hoglet67/ReTuLaReMake/kicad/ReTuLaReMake.pdf

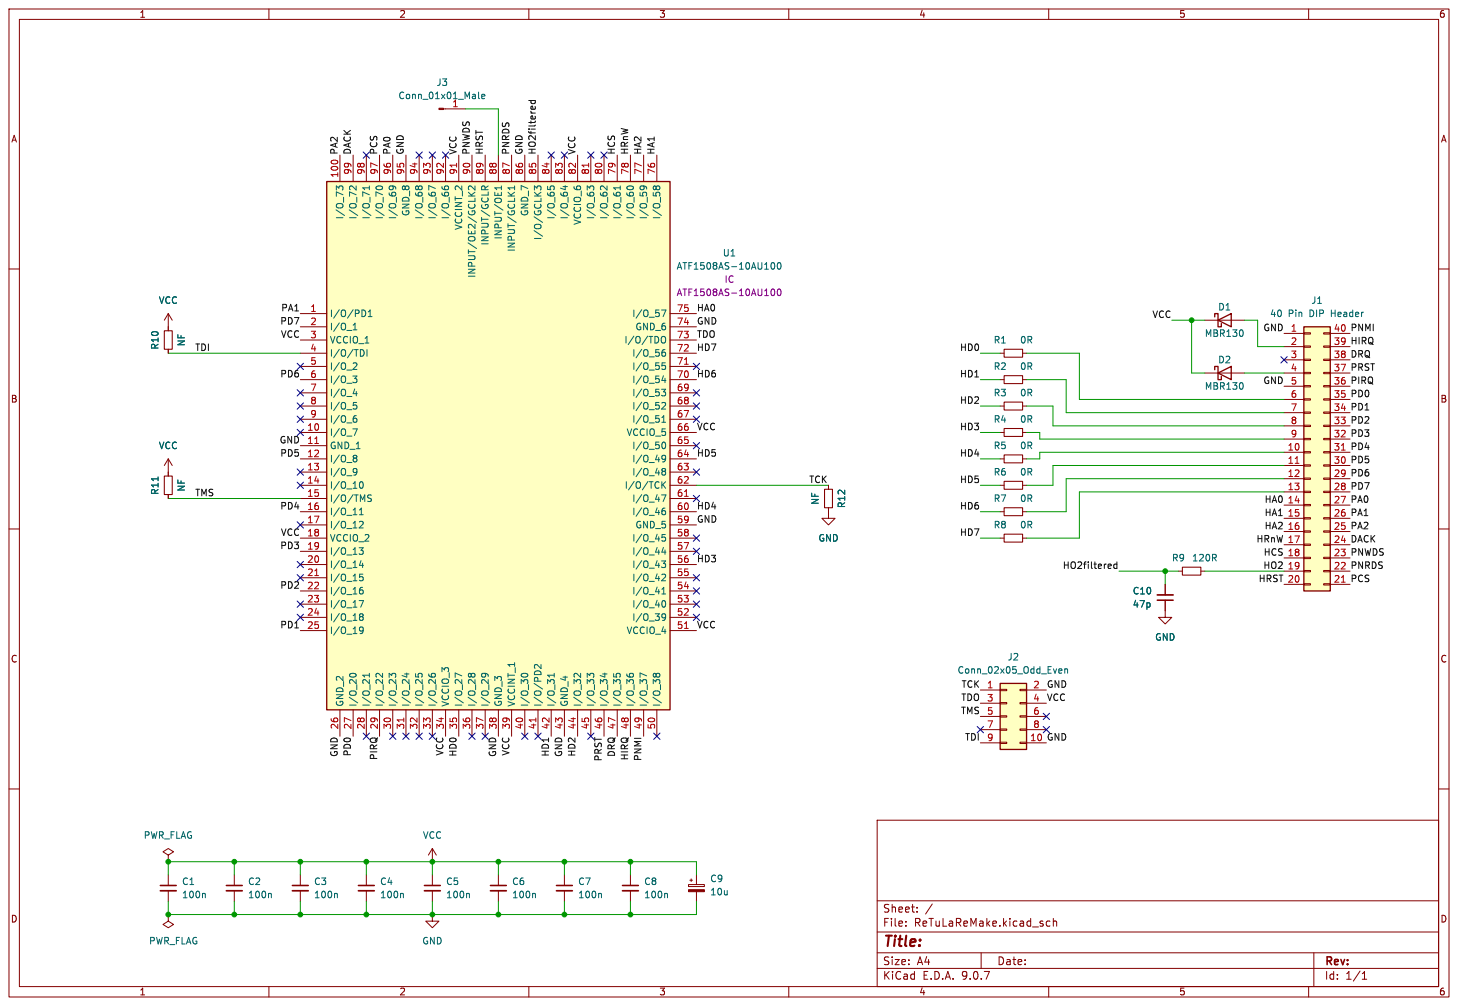
[picture p1: page 1]

Id: 1/1 Title: File: ReTuLaReMake.kicad_sch Sheet: /
