hoglet67/ReTuLaReMake/kicad_jk/ReTuLaReMake.kicad_pcb

## KiCad design kicad_jk/ReTuLaReMake.kicad_pcb (2023-12-09)

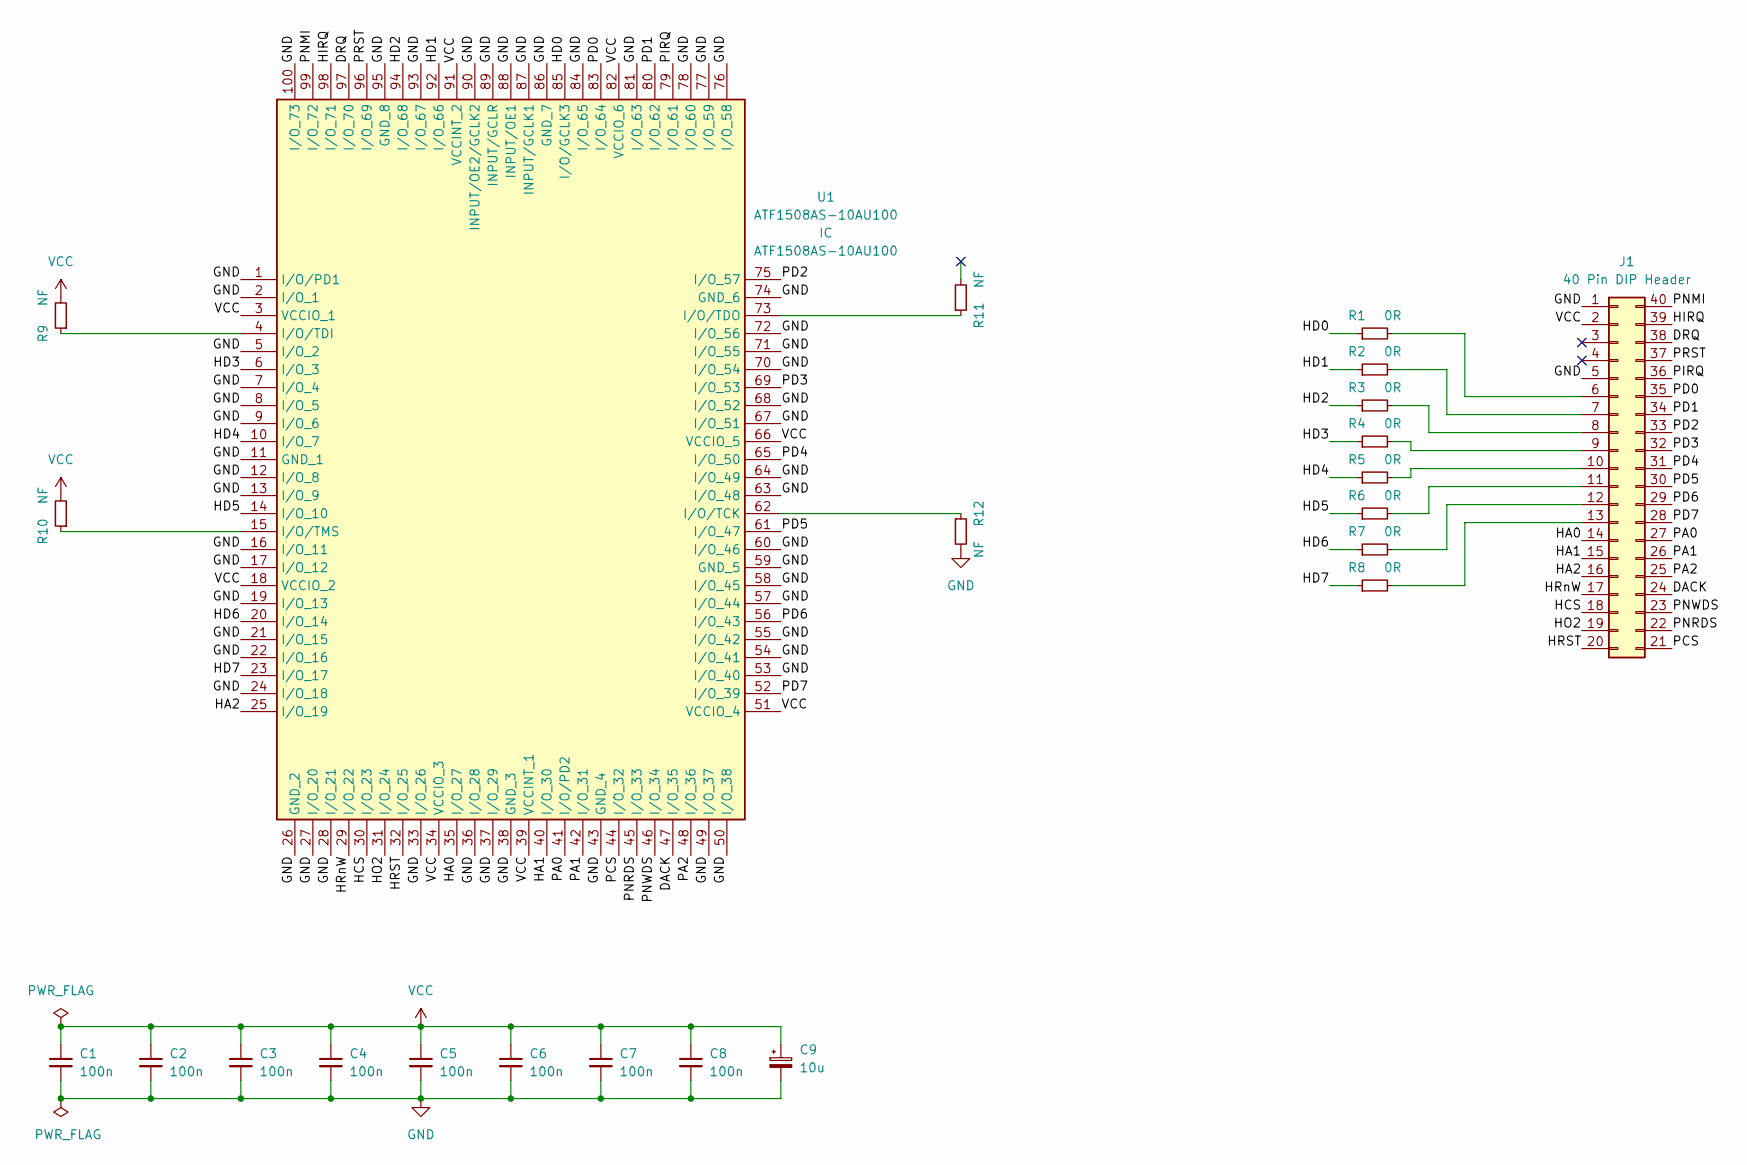
[picture p5: schematic ReTuLaReMake.kicad_sch]

Parts:
C1, C2, C3, C4, C5, C6, C7, C8: 100n; C_0805_2012Metric_Pad1.18x1.45mm_HandSolder
C9: 10u; CP_EIA-6032-28_Kemet-C_Pad2.25x2.35mm_HandSolder
J1: 40 Pin DIP Header; DIP-40_W15.24mm_Header
R1, R2, R3, R4, R5, R6, R7, R8: 0R; R_0805_2012Metric_Pad1.20x1.40mm_HandSolder
R9, R10, R11, R12: NF; R_1206_3216Metric
U1: ATF1508AS-10AU100; TQFP-100_14x14mm_P0.5mm; Manufacturer_Part_Number ATF1508AS-10AU100; Mouser Part Number 556-AF1508AS10AU100

Connections:
/DACK: J1.24, U1.47 (I/O_35)
/DRQ: J1.38, U1.97 (I/O_70)
/HA0: J1.14, U1.35 (I/O_27)
/HA1: J1.15, U1.40 (I/O_30)
/HA2: J1.16, U1.25 (I/O_19)
/HCS: J1.18, U1.30 (I/O_23)
/HD0: R1.1, U1.85 (I/O/GCLK3)
/HD1: R2.1, U1.92 (I/O_66)
/HD2: R3.1, U1.94 (I/O_68)
/HD3: R4.1, U1.6 (I/O_3)
/HD4: R5.1, U1.10 (I/O_7)
/HD5: R6.1, U1.14 (I/O_10)
/HD6: R7.1, U1.20 (I/O_14)
/HD7: R8.1, U1.23 (I/O_17)
/HIRQ: J1.39, U1.98 (I/O_71)
/HO2: J1.19, U1.31 (I/O_24)
/HRST: J1.20, U1.32 (I/O_25)
/HRnW: J1.17, U1.29 (I/O_22)
/PA0: J1.27, U1.41 (I/O/PD2)
/PA1: J1.26, U1.42 (I/O_31)
/PA2: J1.25, U1.48 (I/O_36)
/PCS: J1.21, U1.44 (I/O_32)
/PD0: J1.35, U1.83 (I/O_64)
/PD1: J1.34, U1.80 (I/O_62)
/PD2: J1.33, U1.75 (I/O_57)
/PD3: J1.32, U1.69 (I/O_53)
/PD4: J1.31, U1.65 (I/O_50)
/PD5: J1.30, U1.61 (I/O_47)
/PD6: J1.29, U1.56 (I/O_43)
/PD7: J1.28, U1.52 (I/O_39)
/PIRQ: J1.36, U1.79 (I/O_61)
/PNMI: J1.40, U1.99 (I/O_72)
/PNRDS: J1.22, U1.45 (I/O_33)
/PNWDS: J1.23, U1.46 (I/O_34)
/PRST: J1.37, U1.96 (I/O_69)
GND: C1.2, C2.2, C3.2, C4.2, C5.2, C6.2, C7.2, C8.2, C9.2, J1.1, J1.5, R12.2, U1.1 (I/O/PD1), U1.2 (I/O_1), U1.5 (I/O_2), U1.7 (I/O_4), U1.8 (I/O_5), U1.9 (I/O_6), U1.11 (GND_1), U1.12 (I/O_8), U1.13 (I/O_9), U1.16 (I/O_11), U1.17 (I/O_12), U1.19 (I/O_13), U1.21 (I/O_15), U1.22 (I/O_16), U1.24 (I/O_18), U1.26 (GND_2), U1.27 (I/O_20), U1.28 (I/O_21), U1.33 (I/O_26), U1.36 (I/O_28), U1.37 (I/O_29), U1.38 (GND_3), U1.43 (GND_4), U1.49 (I/O_37), U1.50 (I/O_38), U1.53 (I/O_40), U1.54 (I/O_41), U1.55 (I/O_42), U1.57 (I/O_44), U1.58 (I/O_45), U1.59 (GND_5), U1.60 (I/O_46), U1.63 (I/O_48), U1.64 (I/O_49), U1.67 (I/O_51), U1.68 (I/O_52), U1.70 (I/O_54), U1.71 (I/O_55), U1.72 (I/O_56), U1.74 (GND_6), U1.76 (I/O_58), U1.77 (I/O_59), U1.78 (I/O_60), U1.81 (I/O_63), U1.84 (I/O_65), U1.86 (GND_7), U1.87 (INPUT/GCLK1), U1.88 (INPUT/OE1), U1.89 (INPUT/GCLR), U1.90 (INPUT/OE2/GCLK2), U1.93 (I/O_67), U1.95 (GND_8), U1.100 (I/O_73)
unnamed: J1.6, R1.2
unnamed: J1.7, R2.2
unnamed: J1.8, R3.2
unnamed: J1.9, R4.2
unnamed: J1.10, R5.2
unnamed: J1.11, R6.2
unnamed: J1.12, R7.2
unnamed: J1.13, R8.2
unnamed: R9.1, U1.4 (I/O/TDI)
unnamed: R10.1, U1.15 (I/O/TMS)
unnamed: R11.1, U1.73 (I/O/TDO)
unnamed: R12.1, U1.62 (I/O/TCK)
VCC: C1.1, C2.1, C3.1, C4.1, C5.1, C6.1, C7.1, C8.1, C9.1, J1.2, R9.2, R10.2, U1.3 (VCCIO_1), U1.18 (VCCIO_2), U1.34 (VCCIO_3), U1.39 (VCCINT_1), U1.51 (VCCIO_4), U1.66 (VCCIO_5), U1.82 (VCCIO_6), U1.91 (VCCINT_2)

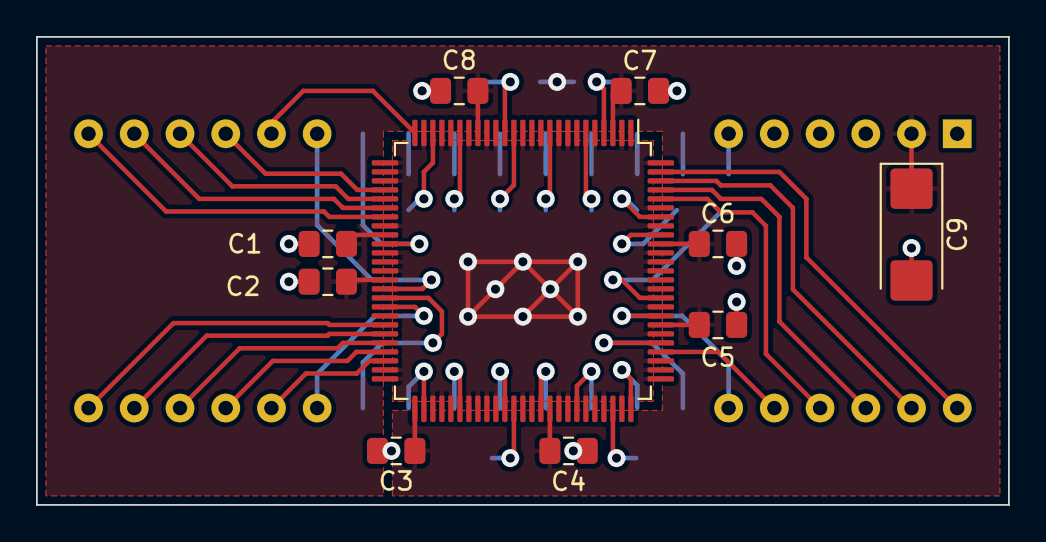
[picture p6: board kicad_jk/ReTuLaReMake.kicad_pcb from above]

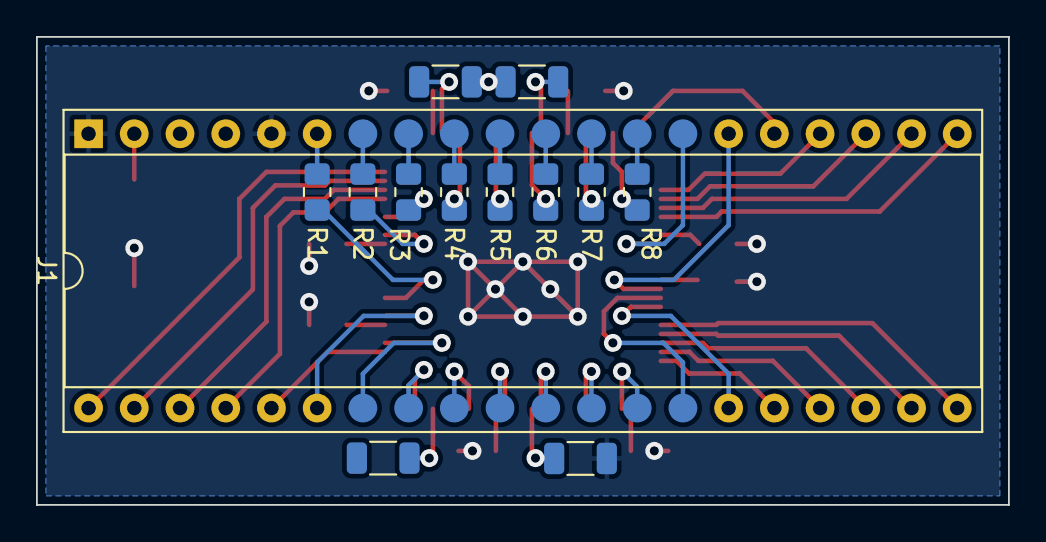
[picture p7: board kicad_jk/ReTuLaReMake.kicad_pcb from below]

Board: 2 copper layers, 54.0 x 26.0 mm, 23 parts (13 on the bottom side), 49 nets.
