hoglet67/ReTuLaReMake/cpld/cupl/simulation/Atmel_Lib.v

//    ---------------------------- Atmel ATF15xx Timing Simulation Library-----------------------------------
//   |Version:                     1.0.3                                                                     |
//   |Last revision date:          01/23/2007                                                                |
//   |Revised by:                  skoutsomitsos                                                             |
//   |                                                                                                       |
//   |Changelog:         1.0.1    -12/19/2006 by skoutsomitsos| New functional models for DFFEARS/TFFEARS    |
//   |                            -12/19/2006 by skoutsomitsos| Corrected timescale and timing values        |                                                          |
//   |                                                          decimals to 1ps                              |
//   |                   1.0.2    -01/12/2007 by ewan         | Set initial state of DFFEARS/TFFEARS to 0    |
//   |                   1.0.3    -01/23/2007 by ewan         | Modified the defined initial state of DFF/TFF|
//    ------------------------------------------------------------------------------------------------------


`timescale 1ns / 1ps

/////////////////////////////////////////////////

module BUF (Q,A);
        output Q;
        input  A;

        buf I1 (Q, A);

 specify
		specparam allZeros = 0:0:0;
                (A +=> Q) = ( allZeros,allZeros);
        endspecify
endmodule // ibuf

/////////////////////////////////////////////////


module INV (QN, A);
	input 	A;
	output 	QN;

not fig1115 ( QN, A );

specify //Path definitions
	(A => QN ) = (0.000:0.000:0.000,0.000:0.000:0.000);

	//Delay Calc Parameter declarations
	specparam fall$A$QN	= 0.000:0.000:0.000;
	specparam rise$A$QN	= 0.000:0.000:0.000;
	specparam load$A	= 1.0;
endspecify
endmodule


////////////////////////////////////////////////

module AND1 (Q, A1);
	input 	A1;
	output 	Q;

buf fig1000 ( Q, A1 );

specify //Path definitions
	(A1 => Q ) = (0.000:0.000:0.000,0.000:0.000:0.000);

	//Delay Calc Parameter declarations
	specparam fall$A1$Q	= 0.000:0.000:0.000;
	specparam rise$A1$Q	= 0.000:0.000:0.000;
	specparam load$A1	= 1.0;
endspecify
endmodule

////////////////////////////////////////////////
module AND2 (Q, A1, A2);
	input 	A1;
	input 	A2;
	output 	Q;

and fig1000 ( Q, A1, A2 );

specify //Path definitions
	(A1 => Q ) = (0.000:0.000:0.000,0.000:0.000:0.000);
	(A2 => Q ) = (0.000:0.000:0.000,0.000:0.000:0.000);

	//Delay Calc Parameter declarations
	specparam fall$A1$Q	= 0.000:0.000:0.000;
	specparam rise$A1$Q	= 0.000:0.000:0.000;
	specparam fall$A2$Q	= 0.000:0.000:0.000;
	specparam rise$A2$Q	= 0.000:0.000:0.000;
	specparam load$A1	= 1.0;
	specparam load$A2	= 1.0;
endspecify
endmodule


//////////////////////////////////////////////////

module AND3 (Q, A1, A2, A3);
	input 	A1;
	input 	A2;
	input 	A3;
	output 	Q;

and fig1211 ( Q, A1, A2, A3);

specify //Path definitions
	(A1 => Q ) = (0.000:0.000:0.000,0.000:0.000:0.000);
	(A2 => Q ) = (0.000:0.000:0.000,0.000:0.000:0.000);
	(A3 => Q ) = (0.000:0.000:0.000,0.000:0.000:0.000);

	//Delay Calc Parameter declarations
	specparam fall$A1$Q	= 0.000:0.000:0.000;
	specparam rise$A1$Q	= 0.000:0.000:0.000;
	specparam fall$A2$Q	= 0.000:0.000:0.000;
	specparam rise$A2$Q	= 0.000:0.000:0.000;
	specparam fall$A3$Q	= 0.000:0.000:0.000;
	specparam rise$A3$Q	= 0.000:0.000:0.000;
	specparam load$A1	= 1.0;
	specparam load$A2	= 1.0;
	specparam load$A3	= 1.0;
endspecify
endmodule

///////////////////////////////////////////////

module AND4 (Q, A1, A2, A3, A4);
	input 	A1;
	input 	A2;
	input 	A3;
	input 	A4;
	output 	Q;

and fig1230 ( Q, A1, A2, A3, A4 );

specify //Path definitions
	(A1 => Q ) = (0.000:0.000:0.000,0.000:0.000:0.000);
	(A2 => Q ) = (0.000:0.000:0.000,0.000:0.000:0.000);
	(A3 => Q ) = (0.000:0.000:0.000,0.000:0.000:0.000);
	(A4 => Q ) = (0.000:0.000:0.000,0.000:0.000:0.000);

	//Delay Calc Parameter declarations
	specparam fall$A1$Q	= 0.000:0.000:0.000;
	specparam rise$A1$Q	= 0.000:0.000:0.000;
	specparam fall$A2$Q	= 0.000:0.000:0.000;
	specparam rise$A2$Q	= 0.000:0.000:0.000;
	specparam fall$A3$Q	= 0.000:0.000:0.000;
	specparam rise$A3$Q	= 0.000:0.000:0.000;
	specparam fall$A4$Q	= 0.000:0.000:0.000;
	specparam rise$A4$Q	= 0.000:0.000:0.000;
	specparam load$A1	= 1.0;
	specparam load$A2	= 1.0;
	specparam load$A3	= 1.0;
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
	specparam rise$A32$Q	= 0.000:0.000:0.000;
	specparam fall$A33$Q	= 0.000:0.000:0.000;
	specparam rise$A33$Q	= 0.000:0.000:0.000;
	specparam fall$A34$Q	= 0.000:0.000:0.000;
	specparam rise$A34$Q	= 0.000:0.000:0.000;
	specparam load$A1	= 1.0;
	specparam load$A2	= 1.0;
	specparam load$A3	= 1.0;
	specparam load$A4	= 1.0;
	specparam load$A5	= 1.0;
	specparam load$A6	= 1.0;
	specparam load$A7	= 1.0;
	specparam load$A8	= 1.0;
	specparam load$A9	= 1.0;
	specparam load$A10	= 1.0;
	specparam load$A11	= 1.0;
	specparam load$A12	= 1.0;
	specparam load$A13	= 1.0;
	specparam load$A14	= 1.0;
	specparam load$A15	= 1.0;
	specparam load$A16	= 1.0;
	specparam load$A17	= 1.0;
	specparam load$A18	= 1.0;
	specparam load$A19	= 1.0;
	specparam load$A20	= 1.0;
	specparam load$A21	= 1.0;
	specparam load$A22	= 1.0;
	specparam load$A23	= 1.0;
	specparam load$A24	= 1.0;
	specparam load$A25	= 1.0;
	specparam load$A26	= 1.0;
	specparam load$A27	= 1.0;
	specparam load$A28	= 1.0;
	specparam load$A29	= 1.0;
	specparam load$A30	= 1.0;
	specparam load$A31	= 1.0;
	specparam load$A32	= 1.0;
	specparam load$A33	= 1.0;
	specparam load$A34	= 1.0;

endspecify
endmodule
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
