hoglet67/ReTuLaReMake/(commit log)

2023-11-27 Initial version
    [ReTuLaReMake.kicad_pcb, ReTuLaReMake.kicad_sch]
2023-11-27 KiCAD: Move PA0
    [ReTuLaReMake.kicad_pcb, ReTuLaReMake.kicad_sch]
2023-11-27 KiCAD: Board settings
    [ReTuLaReMake.kicad_pcb]
2023-11-27 KiCAD: Make VIAs 1.0mm/0.5mm
    [ReTuLaReMake.kicad_pcb]
2023-11-28 KiCAD: Move HD1/0 to valid pins
    [ReTuLaReMake.kicad_pcb, ReTuLaReMake.kicad_sch]
2023-11-29 CPLD: fix bug with nmi flag
    [tube.v]
2023-12-07 CPLD: Fix bug in one-byte R3
    [tube.v]
2023-12-09 CPLD: Add parasite power detection
2023-12-09 KiCAD: Correct pin assignments to match JK's PCBs
    [ReTuLaReMake.kicad_pcb, ReTuLaReMake.kicad_sch]
2023-12-09 KiCAD: Connect unused CPLD pins to GND
    [ReTuLaReMake.kicad_pcb, ReTuLaReMake.kicad_sch]
2023-12-09 CPLD: Refresh Altera pinout to match JK's PCBs
2023-12-09 CPLD: Refresh CUPL pinout to match JK's PCBs
2023-12-09 CPLD: Verilog, added pin assignment for aft15xx_yosys flow
2023-12-11 CPLD: yosys flow, correct fixed pinout
    [tube.v]
2023-12-12 KiCAD: Take snapshot of design with JK's pin allocation
    [ReTuLaReMake.kicad_pcb, ReTuLaReMake.kicad_sch]
2023-12-12 KiCAD: Rotated CPLD 180 degrees and changed pinout
    [ReTuLaReMake.kicad_pcb, ReTuLaReMake.kicad_sch]
2023-12-12 CPLD: yosys flow, update pinout
2024-01-07 CPLD: CUPL, add parasite power detection
2024-01-07 KiCad: Move p_rd_b to a global clock
    [ReTuLaReMake.kicad_pcb, ReTuLaReMake.kicad_sch]
2024-01-07 CPLD: Altera, switch to Atmel pinout
2024-01-07 KiCAD: Added JTAG Connector
    [ReTuLaReMake.kicad_pcb, ReTuLaReMake.kicad_sch]
2024-01-08 CPLD: CUPL, Make nmi_flag a pin node to reduce block fan-in
2024-01-08 KiCAD: Update pins for p_data2/1/0
    [ReTuLaReMake.kicad_pcb, ReTuLaReMake.kicad_sch]
2024-01-08 KiCAD: Add schottky diodes
    [ReTuLaReMake.kicad_pcb, ReTuLaReMake.kicad_sch]
2024-01-08 KiCAD: Add 12V OE1 Test Point
    [ReTuLaReMake.kicad_pcb, ReTuLaReMake.kicad_sch]
2024-01-08 KiCAD: Remove GNDs on unused I/Os
    [ReTuLaReMake.kicad_pcb, ReTuLaReMake.kicad_sch]
2024-01-08 CPLD: CUPL, make reset pinout to reduce block fan-in significantly
2024-01-18 KiCAD: Add clock filter; adjust decoupling
    [ReTuLaReMake.kicad_pcb, ReTuLaReMake.kicad_sch]
2024-01-18 KiCAD: Update header to have four more thru-hole pins
    [ReTuLaReMake.kicad_pcb]
2024-01-18 KiCAD: Improve C7/8 routing
    [ReTuLaReMake.kicad_pcb]
2024-01-18 KiCAD: Improve C5/6 routing
    [ReTuLaReMake.kicad_pcb]
2024-01-18 KiCAD: Check then add manufacturing files
    [ReTuLaReMake-B_Cu.gbl, ReTuLaReMake-B_Mask.gbs, ReTuLaReMake-B_Paste.gbp, ReTuLaReMake-B_Silkscreen.gbo, ReTuLaReMake-Edge_Cuts.gm1, ReTuLaReMake-F_Cu.gtl, ReTuLaReMake-F_Mask.gts, ReTuLaReMake-F_Paste.gtp]
2024-01-19 KiCAD: Add JLCJLCJLCJLC
    [ReTuLaReMake-B_Cu.gbl, ReTuLaReMake-B_Mask.gbs, ReTuLaReMake-B_Paste.gbp, ReTuLaReMake-B_Silkscreen.gbo, ReTuLaReMake-Edge_Cuts.gm1, ReTuLaReMake-F_Cu.gtl, ReTuLaReMake-F_Mask.gts, ReTuLaReMake-F_Paste.gtp]
2024-01-19 KiCAD: Shrink vias to 0.4mm/0.8mm
    [ReTuLaReMake-B_Cu.gbl, ReTuLaReMake-B_Mask.gbs, ReTuLaReMake-B_Paste.gbp, ReTuLaReMake-B_Silkscreen.gbo, ReTuLaReMake-Edge_Cuts.gm1, ReTuLaReMake-F_Cu.gtl, ReTuLaReMake-F_Mask.gts, ReTuLaReMake-F_Paste.gtp]
2024-01-19 KiCAD: Move vias off pads
    [ReTuLaReMake-B_Cu.gbl, ReTuLaReMake-B_Mask.gbs, ReTuLaReMake-B_Paste.gbp, ReTuLaReMake-B_Silkscreen.gbo, ReTuLaReMake-Edge_Cuts.gm1, ReTuLaReMake-F_Cu.gtl, ReTuLaReMake-F_Mask.gts, ReTuLaReMake-F_Paste.gtp]
2024-01-31 CPLD: CUPL, enable pin keeper
2024-02-02 CPLD: CUPL, use reduced power mode on macrocells
2026-10-05 Added PDF schematic of released version
