hoglet67/ReTuLaReMake/(notices)

Notices in the files:
kicad/ReTuLaReMake.kicad_pcb:
(c) 2024 Hoglet
